smr547/ChainCounter/hardware/KiCad/schematic_current_version.pdf

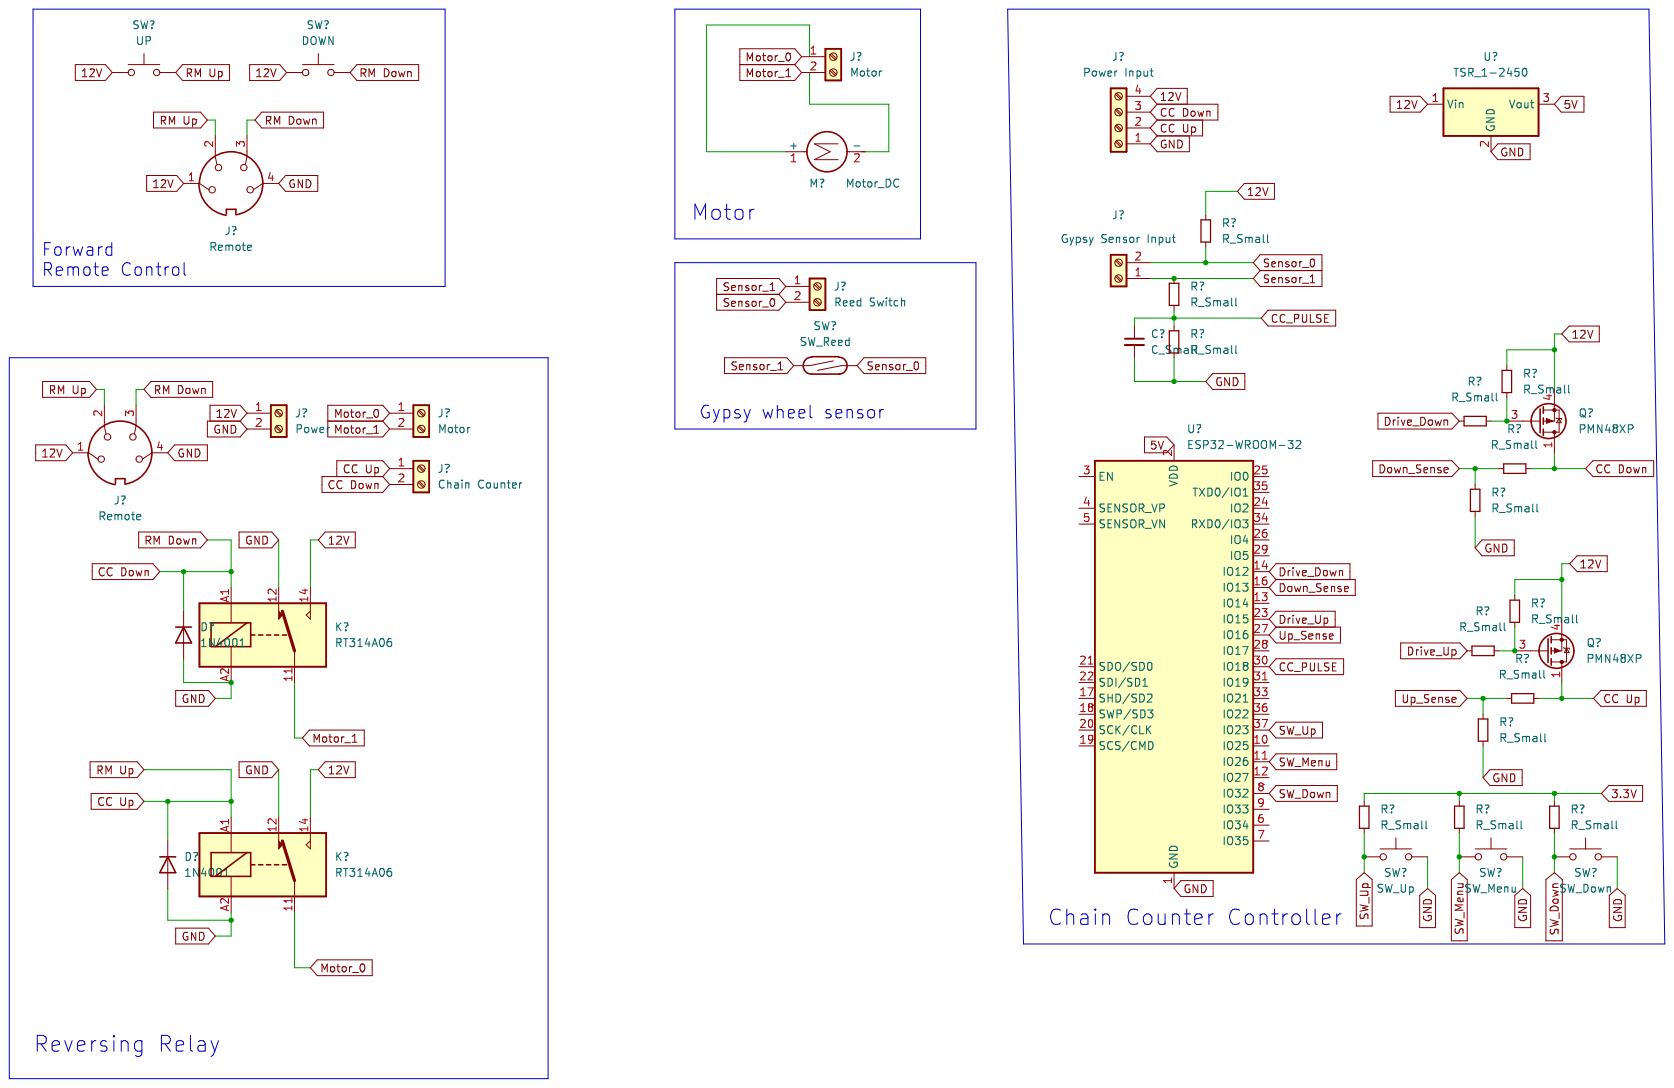
[picture p2: page 1]
