smr547/ChainCounter/hardware/KiCad/Weather Station Interface/Weather Station Interface.kicad_pcb

## KiCad design hardware/KiCad/Weather Station Interface/Weather Station Interface.kicad_pcb (2026-01-23)

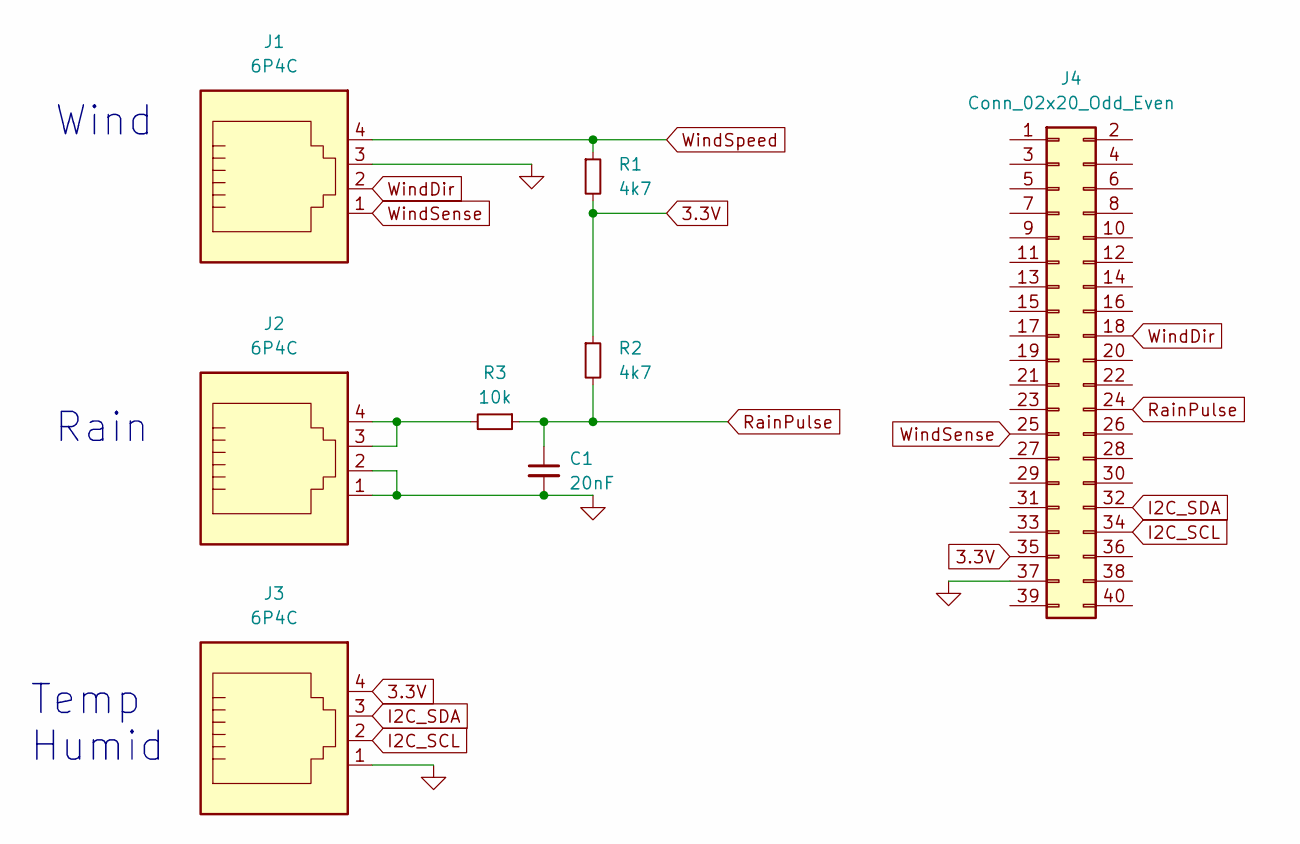
[picture p3: schematic Weather Station Interface.kicad_sch]

Parts:
C1: 20nF; C_1206_3216Metric_Pad1.33x1.80mm_HandSolder
J1, J2, J3: 6P4C; RJ14_Connfly_DS1133-S4_Horizontal
J4: Conn_02x20_Odd_Even; PinSocket_2x20_P2.54mm_Vertical
R1, R2: 4k7; R_0805_2012Metric_Pad1.20x1.40mm_HandSolder
R3: 10k; R_0805_2012Metric_Pad1.20x1.40mm_HandSolder

Connections:
3.3V: J3.4, J4.35, R1.2, R2.1
GND: C1.2, J1.3, J2.1, J2.2, J3.1, J4.37
I2C_SCL: J3.2, J4.34
I2C_SDA: J3.3, J4.32
unnamed: J2.3, J2.4, R3.2
RainPulse: C1.1, J4.24, R2.2, R3.1
WindDir: J1.2, J4.18
WindSense: J1.1, J4.25
WindSpeed: J1.4, R1.1

Notes on the sheet:
Wind
Rain
Temp Humid

Board: 2 copper layers, 8 parts (1 on the bottom side), 9 nets, no tracks yet.
