smr547/ChainCounter/(threads)

Thread 1 (2024-01-20):

Coding template for ISR on ESP32

smr547, 2024-01-20:
It is not clear from the documentation how this should be done

smr547, 2024-01-20:
Some background reading...

* [Arduino framework code for attaching ISRs to pins](https://www.arduino.cc/reference/en/language/functions/external-interrupts/attachinterrupt/)
* [Safely pre-allocating events from an ISR](https://sourceforge.net/p/qpc/discussion/668726/thread/50f10adb/)
* [Configuring and Handling ESP32 GPIO Interrupts In Arduino IDE](https://lastminuteengineers.com/handling-esp32-gpio-interrupts-tutorial/)
* [Working with Events -- Quantum Leaps doco](https://www.state-machine.com/qm/bm_evt.html)
* [About the QP/C Port to FreeRTOS](https://www.state-machine.com/qpc/freertos.html)
* [BSP for DPP on ESP32](https://github.com/vChavezB/qpcpp_esp32/blob/main/examples/dpp_bsp-esp32/bsp.cpp)

smr547, 2024-01-21:
The following code works perfectly (but does nothing) for a button press

```
struct Button {
    const uint8_t PIN;
    unsigned long last_interrupt_ms;
};
Button button = {BUTTON_PIN, 0U};

void BUTTON_ISR(void) {
    BaseType_t xHigherPriorityTaskWoken = pdFALSE;
    unsigned long now_ms = millis();
    if  ((now_ms - button.last_interrupt_ms) >  BUTTON_BOUNCE_SUPPRESS_MS) {
        // not a bounce
        button.last_interrupt_ms = now_ms;
        //event publishing goes here
    } else {
            // key bounce, ignore
    }
    if(xHigherPriorityTaskWoken) {
        portYIELD_FROM_ISR();
    }
}
```

Don't put a ``Serial.println()`` call in the ISR, the chip will reset randomly

smr547, 2024-01-21:
[Very interesting comments here](https://sourceforge.net/p/qpc/discussion/668726/thread/4795147f03/?page=1) from Miro and Andy (the author of the QP ESP32 port)

smr547, 2024-01-21:
Victor Chavez [QP/C++ port to ESP32 on GitHub](https://github.com/vChavezB/qpcpp_esp32)

smr547, 2024-01-21:
Further [discussion about the QP/ESP32/FreeRTOS port](https://sourceforge.net/p/qpc/discussion/668726/thread/402798b36c/) -- experimental only and with questionable parentage.
