smr547/ChainCounter/(commit log)

2024-01-17 Initial hardware design using KiCad
    [chain_counter.kicad_pcb, chain_counter.kicad_sch]
2024-01-17 Photos of old chain counter
2024-01-17 Add chain counter manual
